an7imp/STM32F3-Real-Time-Embedded-Synth/analysis/results/oscillator_spectrum_naive.png

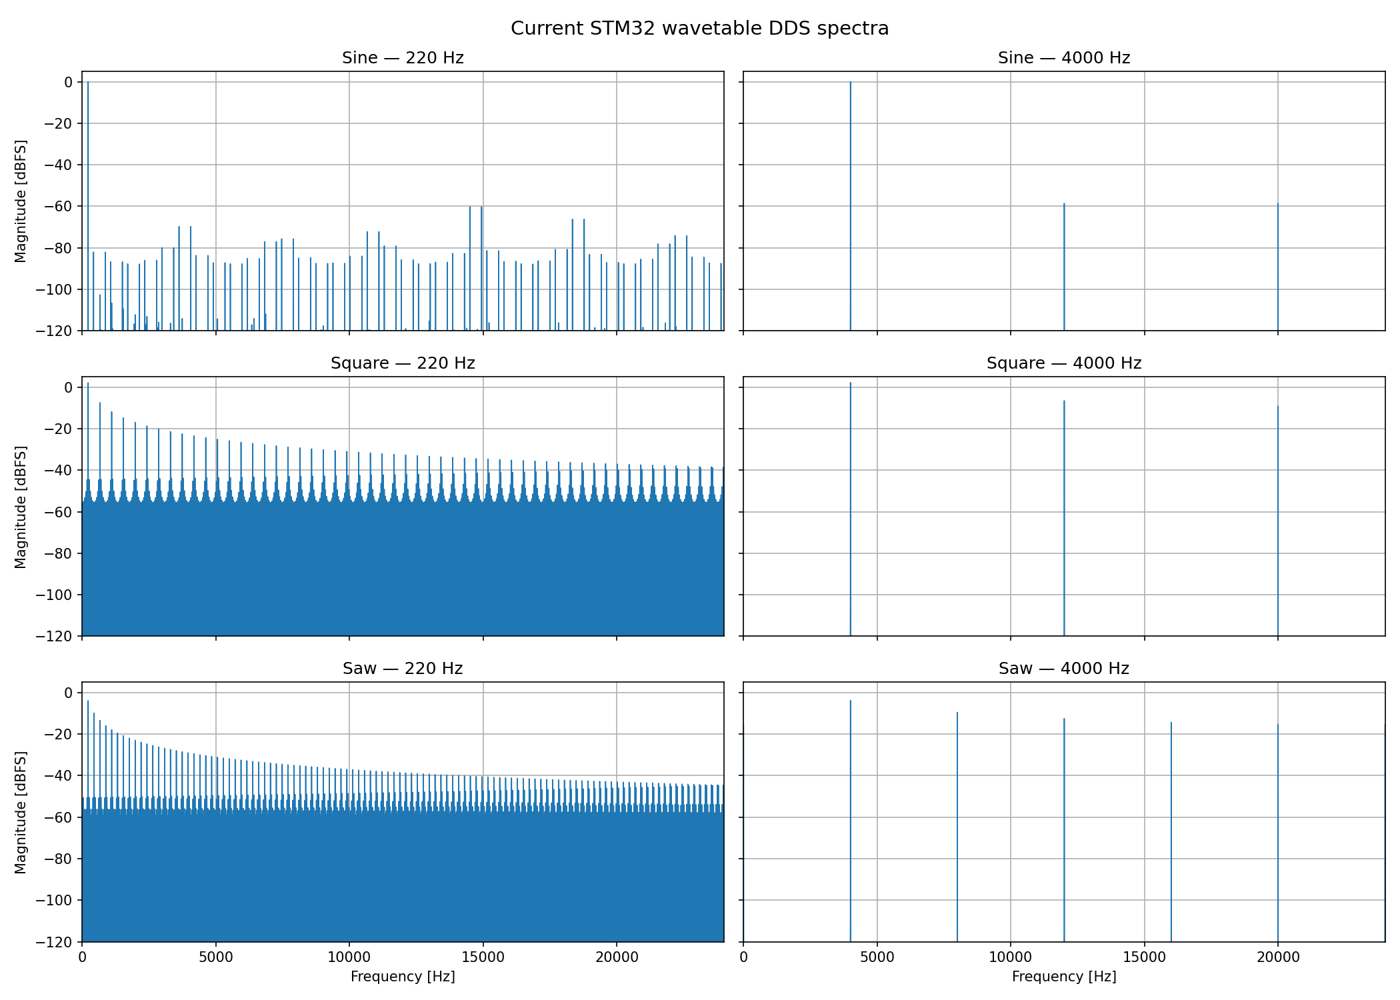
analysis/results/oscillator_spectrum_naive.png
