an7imp/STM32F3-Real-Time-Embedded-Synth/analysis/results/cutoff_comparison.png

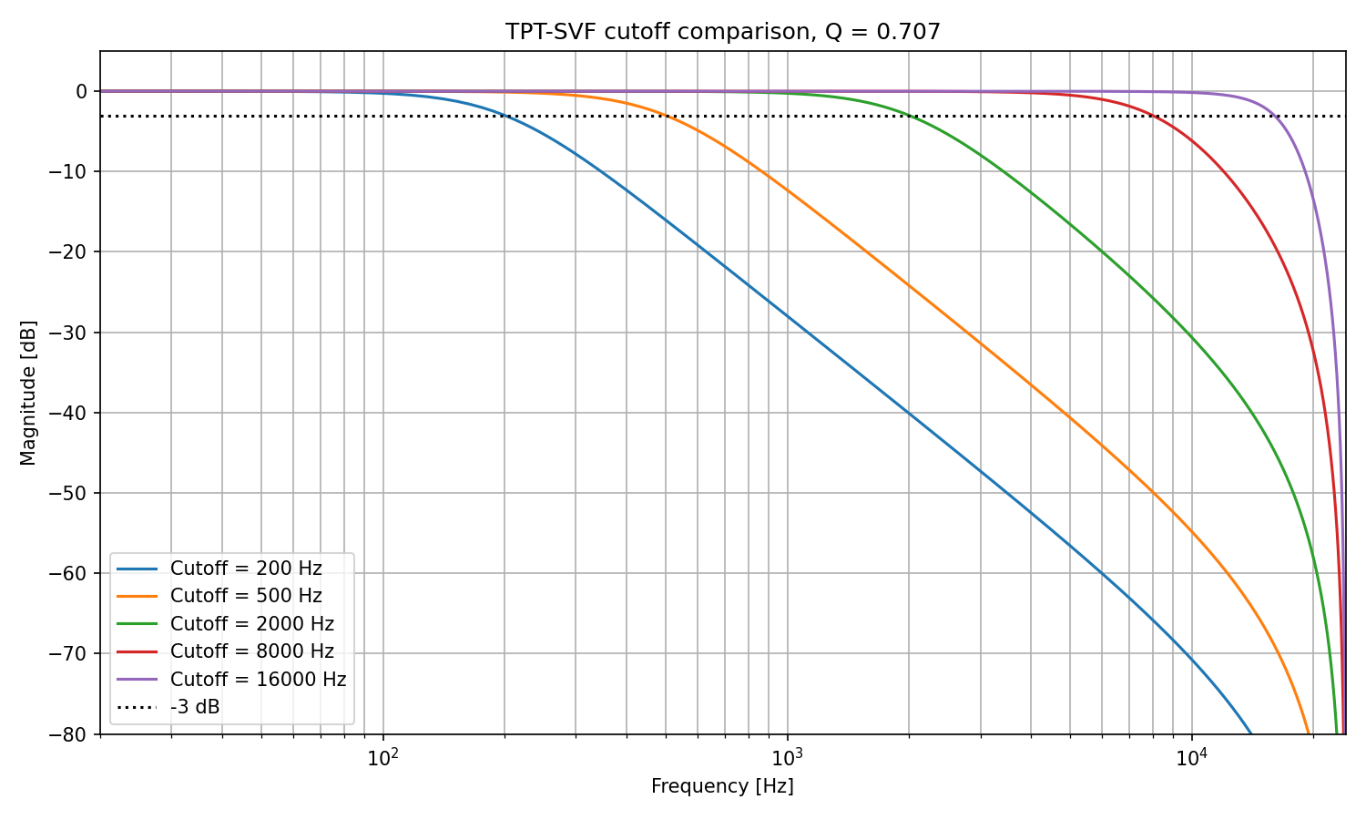
analysis/results/cutoff_comparison.png
