an7imp/STM32F3-Real-Time-Embedded-Synth/analysis/results/frequency_response.png

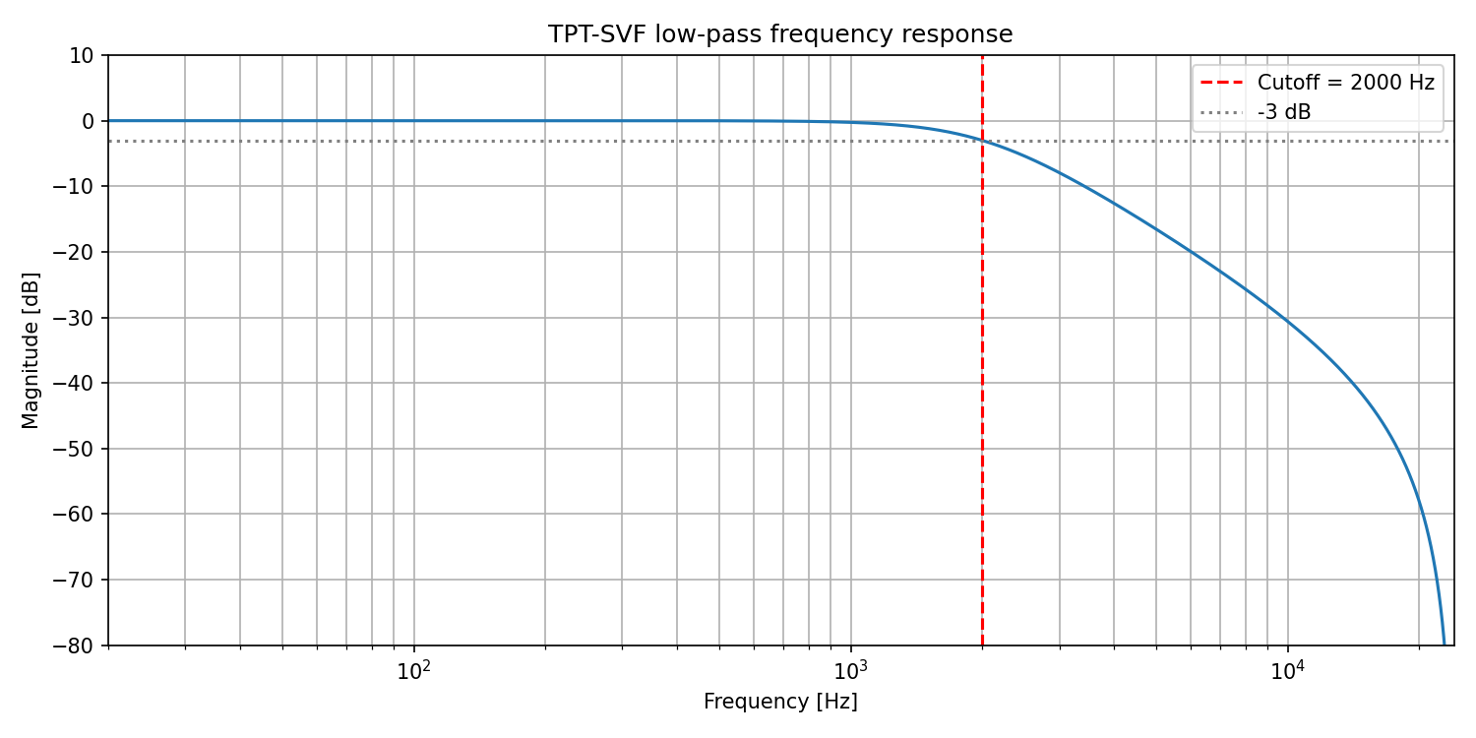
analysis/results/frequency_response.png
