an7imp/STM32F3-Real-Time-Embedded-Synth/analysis/results/impulse_response.png

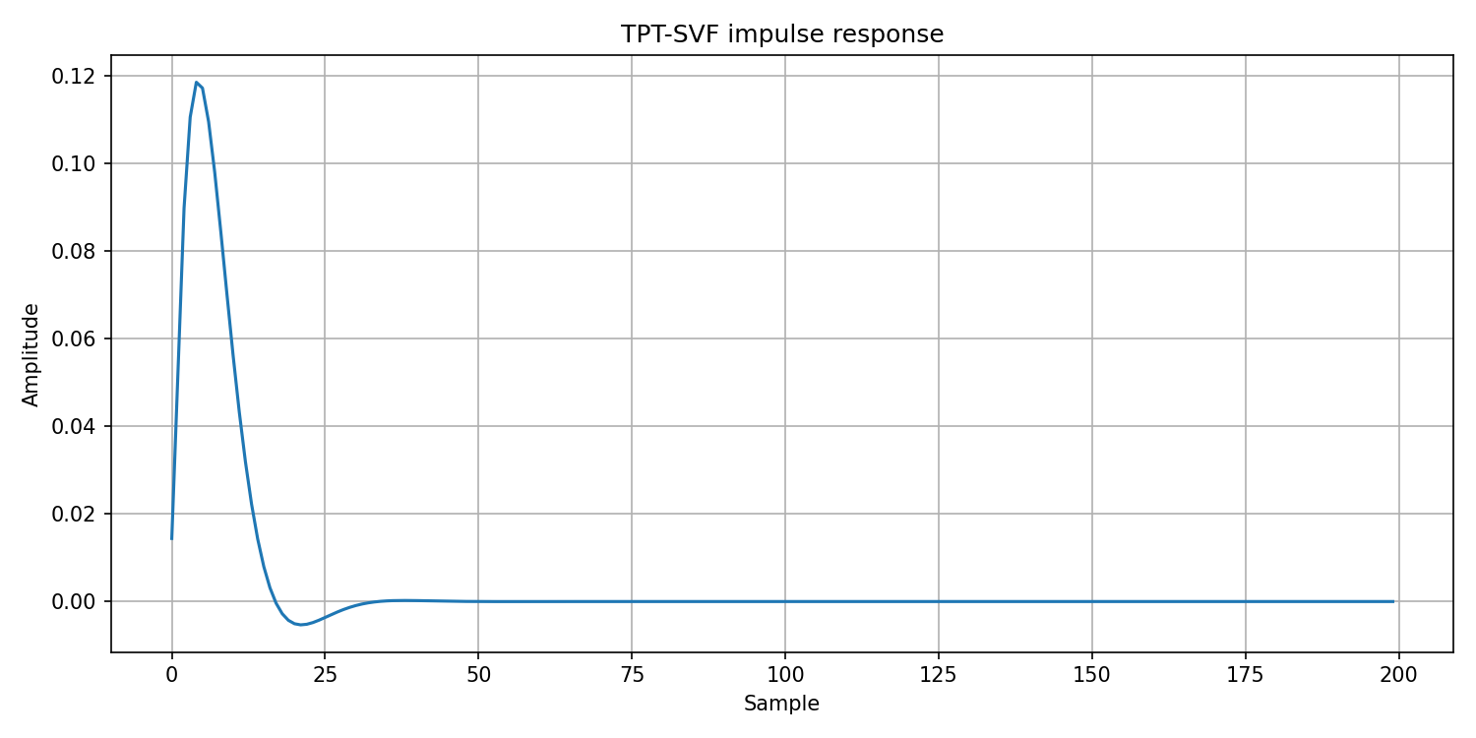
analysis/results/impulse_response.png
