an7imp/STM32F3-Real-Time-Embedded-Synth/analysis/results/q_comparison.png

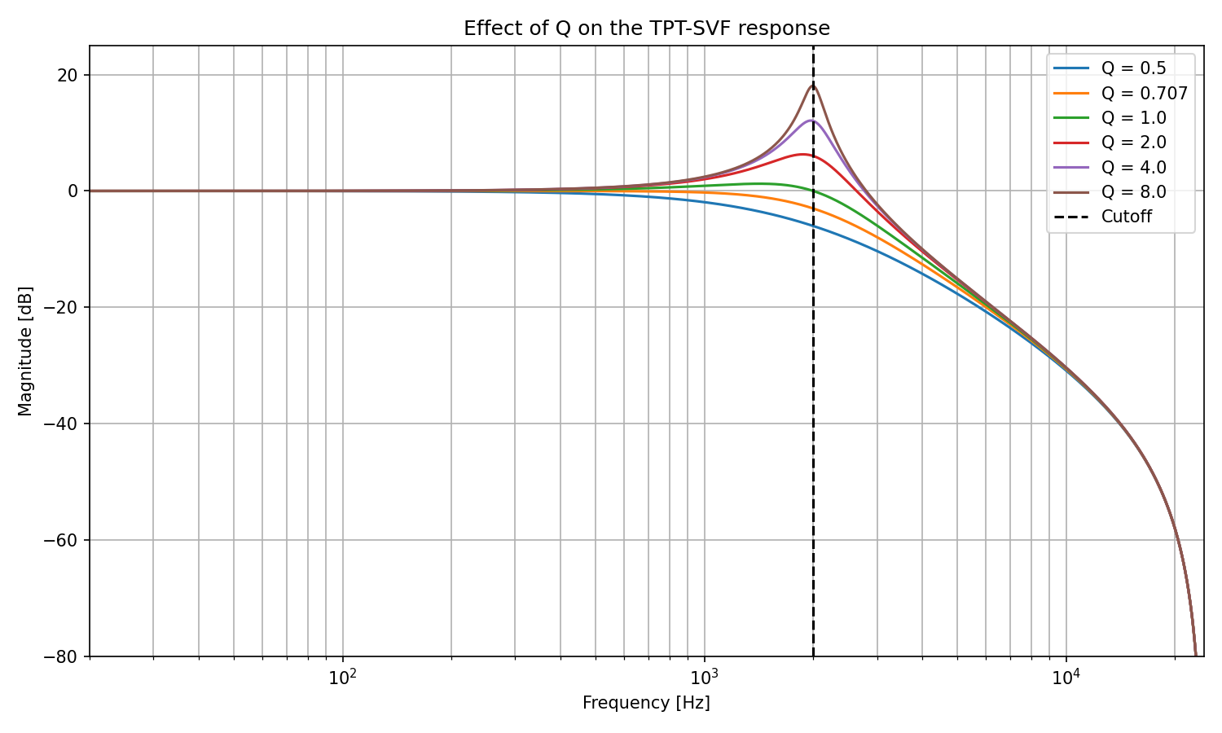
analysis/results/q_comparison.png
