an7imp/STM32F3-Real-Time-Embedded-Synth/ST/STM32F3_Embedded_Synth/Core/Src/main.c

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
/* Includes ------------------------------------------------------------------*/
#include "main.h"

/* USER CODE BEGIN Includes */
#include "math.h"
#include "adsr.h"
#include "audio_config.h"
#include "midi_mapping.h"
#include "oscillator.h"
#include "oscillator_tables.h"
#include "svf_filter.h"

//MIDI
#define MIDI_NOTE_ON  0x90
#define MIDI_NOTE_OFF 0x80
#define MIDI_CONTROL_CHANGE 0xB0
#define MIDI_BUF_LEN 64

uint8_t midi_ring_buffer[MIDI_BUF_LEN];
volatile uint8_t midi_read_idx = 0, midi_write_idx = 0;

uint8_t rx_byte;

uint8_t status;
uint8_t note;
uint8_t velocity;
uint8_t active_note = 0xFFU;
uint8_t held_notes[128];
uint32_t note_press_order[128];
uint32_t note_order_counter = 0;
// Ultimo valore ricevuto per ciascun MIDI Control Change (CC 0-127).
// Questi valori verranno successivamente associati a filtro e ADSR.
volatile uint8_t midi_cc_values[128];
volatile uint8_t last_cc_number = 0;
volatile uint8_t last_cc_value = 0;

float midi_freq = 0;
volatile uint8_t sound_enabled = 0;

typedef struct {
    uint32_t note_on_count;
    uint32_t note_off_count;
    uint32_t control_change_count;
    uint32_t dropped_bytes;
} MIDI_Diagnostics;

typedef struct {
    uint32_t error_count;
    uint32_t overrun_count;
} UART_Diagnostics;

typedef struct {
    uint8_t active_note;
    uint8_t state;
    float level;
} ADSR_Diagnostics;

typedef struct {
    uint32_t clipping_count;
    uint32_t non_finite_count;
    float cutoff_hz;
    float q;
} Filter_Diagnostics;

typedef struct {
    uint32_t last_cycles;
    uint32_t max_cycles;
    uint32_t deadline_cycles;
    uint32_t deadline_miss_count;
} Audio_Diagnostics;

typedef struct {
    uint8_t mipmapped_enabled;
    uint8_t interpolation_enabled;
    uint8_t active_mip_level;
    uint8_t waveform;
    uint16_t max_harmonic;
    uint32_t phase_increment;
    float frequency_hz;
} Oscillator_Diagnostics;

typedef struct {
    MIDI_Diagnostics midi;
    UART_Diagnostics uart;
    ADSR_Diagnostics adsr;
    Filter_Diagnostics filter;
    Audio_Diagnostics audio;
    Oscillator_Diagnostics oscillator;
} DebugStatus;

#ifdef DEBUG
volatile DebugStatus debug_status = {
    .adsr.active_note = 0xFFU
};
#define DEBUG_INCREMENT(field) (debug_status.field++)
#define DEBUG_SET(field, value) (debug_status.field = (value))
#else
#define DEBUG_INCREMENT(field) ((void)0)
#define DEBUG_SET(field, value) ((void)0)
#endif

//DAC
#define I2S_BUFFER_SIZE 512  // numero di campioni stereo (L+R = 2 x mono)

extern I2S_HandleTypeDef hi2s2;

int16_t i2s_buffer[I2S_BUFFER_SIZE * 2]; // stereo


/* USER CODE END Includes */

I2C_HandleTypeDef hi2c1;

I2S_HandleTypeDef hi2s2;
DMA_HandleTypeDef hdma_spi2_tx;

SPI_HandleTypeDef hspi1;

UART_HandleTypeDef huart1;

PCD_HandleTypeDef hpcd_USB_FS;

void SystemClock_Config(void);
static void MX_GPIO_Init(void);
static void MX_DMA_Init(void);
static void MX_I2C1_Init(void);
static void MX_SPI1_Init(void);
static void MX_USB_PCD_Init(void);
static void MX_I2S2_Init(void);
static void MX_USART1_UART_Init(void);
/* USER CODE BEGIN PFP */
static void SetMIDINoteFrequency(uint8_t midi_note) {
    midi_freq = 440.0f * powf(2.0f, ((float)midi_note - 69.0f) / 12.0f);
    SetFrequency(midi_freq);
}

static uint8_t FindMostRecentHeldNote(void) {
    uint8_t selected_note = 0xFFU;
    uint32_t newest_order = 0U;

    for (uint16_t candidate = 0; candidate < 128U; candidate++) {
        if (held_notes[candidate] != 0U &&
            note_press_order[candidate] >= newest_order) {
            selected_note = (uint8_t)candidate;
            newest_order = note_press_order[candidate];
        }
    }

    return selected_note;
}

static void HandleMIDINoteOn(uint8_t midi_note) {
    held_notes[midi_note] = 1U;
    note_press_order[midi_note] = ++note_order_counter;
    active_note = midi_note;
    DEBUG_SET(adsr.active_note, active_note);

    SetMIDINoteFrequency(midi_note);
    sound_enabled = 1U;
    ADSR_NoteOn();
}

static void HandleMIDINoteOff(uint8_t midi_note) {
    uint8_t fallback_note;

    held_notes[midi_note] = 0U;

    if (midi_note != active_note) {
        return;
    }

    fallback_note = FindMostRecentHeldNote();

    if (fallback_note != 0xFFU) {
        // PrioritÃ  all'ultima nota ancora premuta, senza riattivare l'inviluppo.
        active_note = fallback_note;
        DEBUG_SET(adsr.active_note, active_note);
        SetMIDINoteFrequency(fallback_note);
    } else {
        active_note = 0xFFU;
        DEBUG_SET(adsr.active_note, active_note);
        ADSR_NoteOff();
    }
}

//buffer audio
void FillI2SBuffer(int16_t *buffer, uint16_t length) {
    #ifdef DEBUG
    uint32_t start_cycles = DWT->CYCCNT;
#endif
    //smoothing filter parameters
    filter_cutoff_hz +=
        0.2f * (filter_cutoff_target_hz - filter_cutoff_hz);

    filter_q +=
        0.2f * (filter_q_target - filter_q);

    SVF_SetParameters(
        &lowpass_filter,
        filter_cutoff_hz,
        filter_q,
        (float)SAMPLE_RATE
    );

    float filter_gain = 1.0f;

    if (filter_gain_compensation_enabled) {
        if (filter_q > 1.0f) {
            filter_gain = 1.0f / sqrtf(filter_q);
        }
    }
        
    for (uint16_t i = 0; i < length; i += 2) {

    	if(sound_enabled==1){


        float oscillator_sample = Oscillator_ProcessSample();
        float envelope = ADSR_ProcessSample();
        
        // Oscillator sample is already normalized to the range -1.0 to 1.0.
        float input_sample = oscillator_sample * envelope;

        // Apply low-pass filter

        float lowpass_sample = SVF_ProcessLowpass(&lowpass_filter, input_sample*filter_gain);

        float filtered_sample;

        if (filter_enabled == 1) {
            filtered_sample = lowpass_sample;
        } else {
            filtered_sample = input_sample;
        }

        //diagnostic: check for non-finite values
        if (!isfinite(filtered_sample)) {
        DEBUG_INCREMENT(filter.non_finite_count);

        filtered_sample = 0.0f;
        SVF_Reset(&lowpass_filter);
        }


        //saturation
        if (filtered_sample > 1.0f) {
            DEBUG_INCREMENT(filter.clipping_count);
            filtered_sample = 1.0f;
        } else if (filtered_sample < -1.0f) {
            DEBUG_INCREMENT(filter.clipping_count);
            filtered_sample = -1.0f;
        }

        //convert to pcm 16 bit format
        int16_t output_sample =(int16_t)(filtered_sample * 32767.0f);

        //output mono sample
        buffer[i] = output_sample;     // Left
        buffer[i + 1] = output_sample; // Right
    	}else{
    		buffer[i] = 0;     // Left
    		buffer[i + 1] = 0;
    	}
    }

    if (sound_enabled == 0U) {
    SVF_Reset(&lowpass_filter);
    }

    DEBUG_SET(adsr.state, (uint8_t)adsr_state);
    DEBUG_SET(adsr.level, adsr_level);
    DEBUG_SET(filter.cutoff_hz, filter_cutoff_hz);
    DEBUG_SET(filter.q, filter_q);
    DEBUG_SET(oscillator.mipmapped_enabled, oscillator_mipmapped_enabled);
    DEBUG_SET(oscillator.interpolation_enabled, wavetable_interpolation_enabled);
    DEBUG_SET(oscillator.active_mip_level, active_mip_level);
    DEBUG_SET(oscillator.waveform, wave);
    DEBUG_SET(oscillator.max_harmonic,
              oscillator_mip_max_harmonic[active_mip_level]);
    DEBUG_SET(oscillator.phase_increment, phase_increment);
    DEBUG_SET(oscillator.frequency_hz, current_frequency);

    #ifdef DEBUG
        uint32_t elapsed_cycles = DWT->CYCCNT - start_cycles;
        uint32_t audio_frames = length / 2U;

        uint32_t deadline_cycles =
            (uint32_t)(((uint64_t)SystemCoreClock * audio_frames)
                    / SAMPLE_RATE);

        debug_status.audio.last_cycles = elapsed_cycles;
        debug_status.audio.deadline_cycles = deadline_cycles;

        if (elapsed_cycles > debug_status.audio.max_cycles) {
            debug_status.audio.max_cycles = elapsed_cycles;
        }

        if (elapsed_cycles > deadline_cycles) {
            debug_status.audio.deadline_miss_count++;
        }
    #endif


}

//DMA

void HAL_I2S_TxHalfCpltCallback(I2S_HandleTypeDef *hi2s) {
	//scrivo nella prima metÃ 
    FillI2SBuffer(i2s_buffer, I2S_BUFFER_SIZE);
}


void HAL_I2S_TxCpltCallback(I2S_HandleTypeDef *hi2s) {
	//scrivo nella seconda metÃ 
    FillI2SBuffer(&i2s_buffer[I2S_BUFFER_SIZE], I2S_BUFFER_SIZE);
}

//inizializzazione
void StartDDSOutput(void) {
    GenerateSampleTable();
    SetFrequency(current_frequency);
    FillI2SBuffer(i2s_buffer, I2S_BUFFER_SIZE * 2);
    HAL_I2S_Transmit_DMA(&hi2s2,(uint16_t *) i2s_buffer, I2S_BUFFER_SIZE * 2);
}

//ricezione USART1
void HAL_UART_RxCpltCallback(UART_HandleTypeDef *huart) {
	uint8_t next_write_idx = (uint8_t)((midi_write_idx + 1U) % MIDI_BUF_LEN);

	if (next_write_idx != midi_read_idx) {
		midi_ring_buffer[midi_write_idx] = rx_byte;
		midi_write_idx = next_write_idx;
	} else {
		// Buffer pieno: non sovrascrivere byte MIDI non ancora elaborati.
		DEBUG_INCREMENT(midi.dropped_bytes);
	}

	HAL_UART_Receive_IT(&huart1, &rx_byte, 1);
	}

void HAL_UART_ErrorCallback(UART_HandleTypeDef *huart) {
	if (huart->Instance == USART1) {
		DEBUG_INCREMENT(uart.error_count);

		if ((huart->ErrorCode & HAL_UART_ERROR_ORE) != 0U) {
			DEBUG_INCREMENT(uart.overrun_count);
			__HAL_UART_CLEAR_OREFLAG(huart);
		}

		// Riavvia sempre la ricezione dopo un errore, evitando che una nota
		// resti attiva perchÃ© il relativo Note Off non viene piÃ¹ ricevuto.
		HAL_UART_Receive_IT(&huart1, &rx_byte, 1);
	}
}

void ProcessMIDI(void) {
    static uint8_t running_status = 0;
    static uint8_t midi_data[2];
    static uint8_t data_index = 0;

    uint8_t byte = midi_ring_buffer[midi_read_idx];
    midi_read_idx = (uint8_t)((midi_read_idx + 1U) % MIDI_BUF_LEN);

    if ((byte & 0x80U) != 0U) {
        // I messaggi channel voice (0x80-0xEF) possono usare il running status.
        if (byte < 0xF0U) {
            running_status = byte;
            data_index = 0;
        } else {
            // I messaggi system non sono usati dal sintetizzatore.
            running_status = 0;
            data_index = 0;
        }
        return;
    }

    if (running_status == 0U) {
        return;
    }

    midi_data[data_index++] = byte;

    if (data_index == 2U) {
        uint8_t message_type = running_status & 0xF0U;
        uint8_t data_1 = midi_data[0];
        uint8_t data_2 = midi_data[1];
        data_index = 0;

        status = running_status;

        if (message_type == MIDI_CONTROL_CHANGE) {
            DEBUG_INCREMENT(midi.control_change_count);
            last_cc_number = data_1;
            last_cc_value = data_2;
            midi_cc_values[data_1] = data_2;
            MIDI_ApplyControlChange(data_1, data_2);
        } else {
            note = data_1;
            velocity = data_2;

            if (message_type == MIDI_NOTE_ON && velocity > 0U) {
                DEBUG_INCREMENT(midi.note_on_count);
                HandleMIDINoteOn(note);
            } else if (message_type == MIDI_NOTE_OFF ||
                       (message_type == MIDI_NOTE_ON && velocity == 0U)) {
                DEBUG_INCREMENT(midi.note_off_count);
                HandleMIDINoteOff(note);
            }
    }
}
}

void HAL_GPIO_EXTI_Callback(uint16_t GPIO_Pin){
	wave = (wave + 1) % 3;
	GenerateSampleTable();
	switch(wave){
	case 0: HAL_GPIO_WritePin(GPIOE, GPIO_PIN_8, GPIO_PIN_SET); HAL_GPIO_WritePin(GPIOE, GPIO_PIN_10, GPIO_PIN_RESET); break;
	case 1: HAL_GPIO_WritePin(GPIOE, GPIO_PIN_9, GPIO_PIN_SET); HAL_GPIO_WritePin(GPIOE, GPIO_PIN_8, GPIO_PIN_RESET); break;
	case 2: HAL_GPIO_WritePin(GPIOE, GPIO_PIN_10, GPIO_PIN_SET); HAL_GPIO_WritePin(GPIOE, GPIO_PIN_9, GPIO_PIN_RESET); break;
	default: break;
	}

}
/* USER CODE END PFP */

/**
  * @brief  The application entry point.
  * @retval int
  */
int main(void)
{

  /* MCU Configuration--------------------------------------------------------*/

  /* Reset of all peripherals, Initializes the Flash interface and the Systick. */
  HAL_Init();

  /* Configure the system clock */
  SystemClock_Config();

  /* Initialize all configured peripherals */
  MX_GPIO_Init();
  MX_DMA_Init();
  MX_I2C1_Init();
  MX_SPI1_Init();
  MX_USB_PCD_Init();
  MX_I2S2_Init();
  MX_USART1_UART_Init();
  /* USER CODE BEGIN 2 */
  HAL_GPIO_WritePin(GPIOE, GPIO_PIN_8, GPIO_PIN_SET);
  HAL_UART_Receive_IT(&huart1, &rx_byte, 1);
  SVF_Reset(&lowpass_filter);
  SVF_SetParameters(&lowpass_filter, filter_cutoff_hz, filter_q, (float)SAMPLE_RATE);

  #ifdef DEBUG
  CoreDebug->DEMCR |= CoreDebug_DEMCR_TRCENA_Msk;
  DWT->CYCCNT = 0U;
  DWT->CTRL |= DWT_CTRL_CYCCNTENA_Msk;
  #endif

  StartDDSOutput();
  /* USER CODE END 2 */

  /* Infinite loop */
  /* USER CODE BEGIN WHILE */
  while (1)
  {
	  if(midi_read_idx != midi_write_idx) {
		  ProcessMIDI();
	  }
    /* USER CODE END WHILE */

    /* USER CODE BEGIN 3 */
  }
  /* USER CODE END 3 */
}

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
