an7imp/STM32F3-Real-Time-Embedded-Synth/(notices)

Notices in the files:
ST/STM32F3_Embedded_Synth/Core/Inc/main.h:
Copyright (c) 2025 STMicroelectronics.
All rights reserved.
This software is licensed under terms that can be found in the LICENSE file
